michal6271/PEUS/Projekt EAGLE/zasilacz.pdf

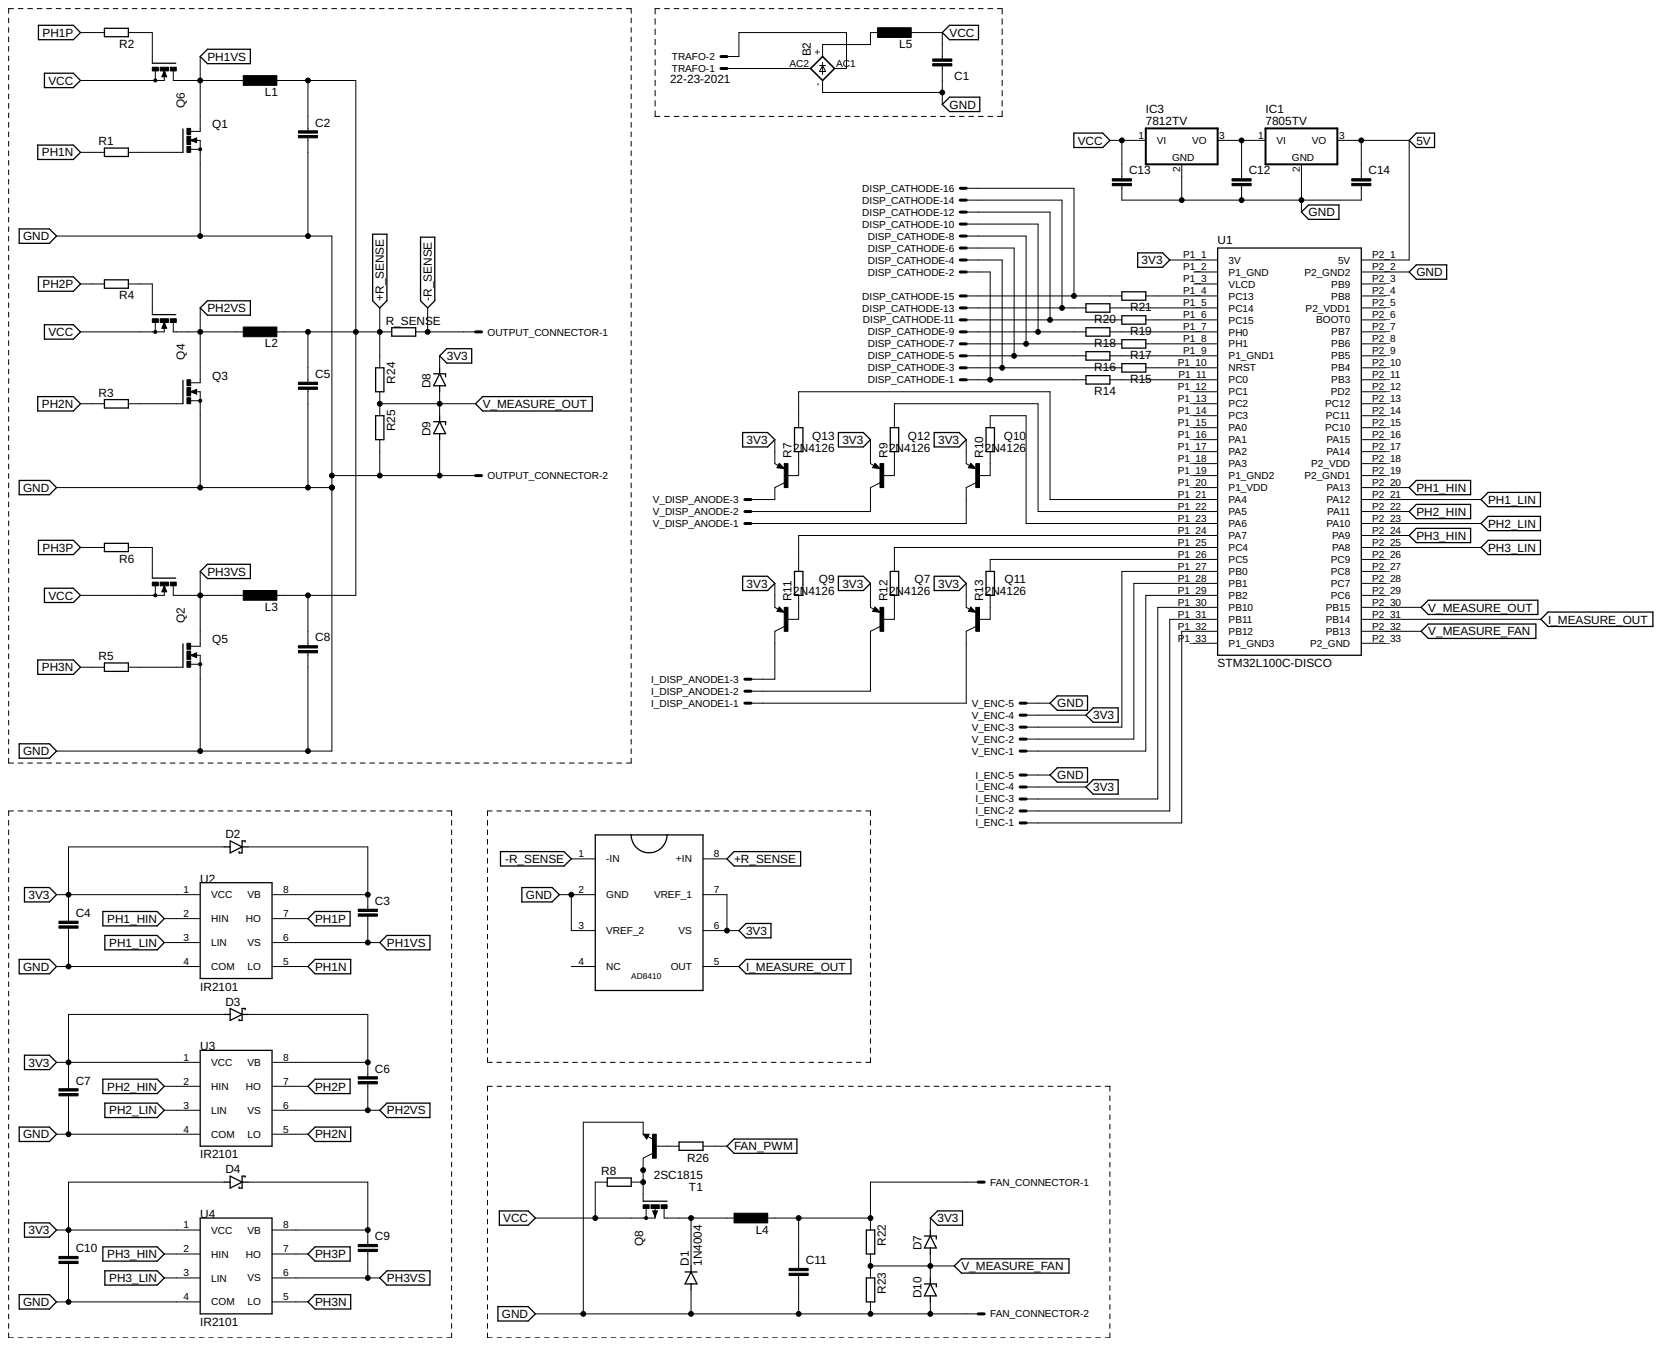
[picture p9: page 1]
