michal6271/PEUS/Projekt EAGLE/zasilacz.brd

## EAGLE design Projekt EAGLE/zasilacz.brd (2021-01-22)

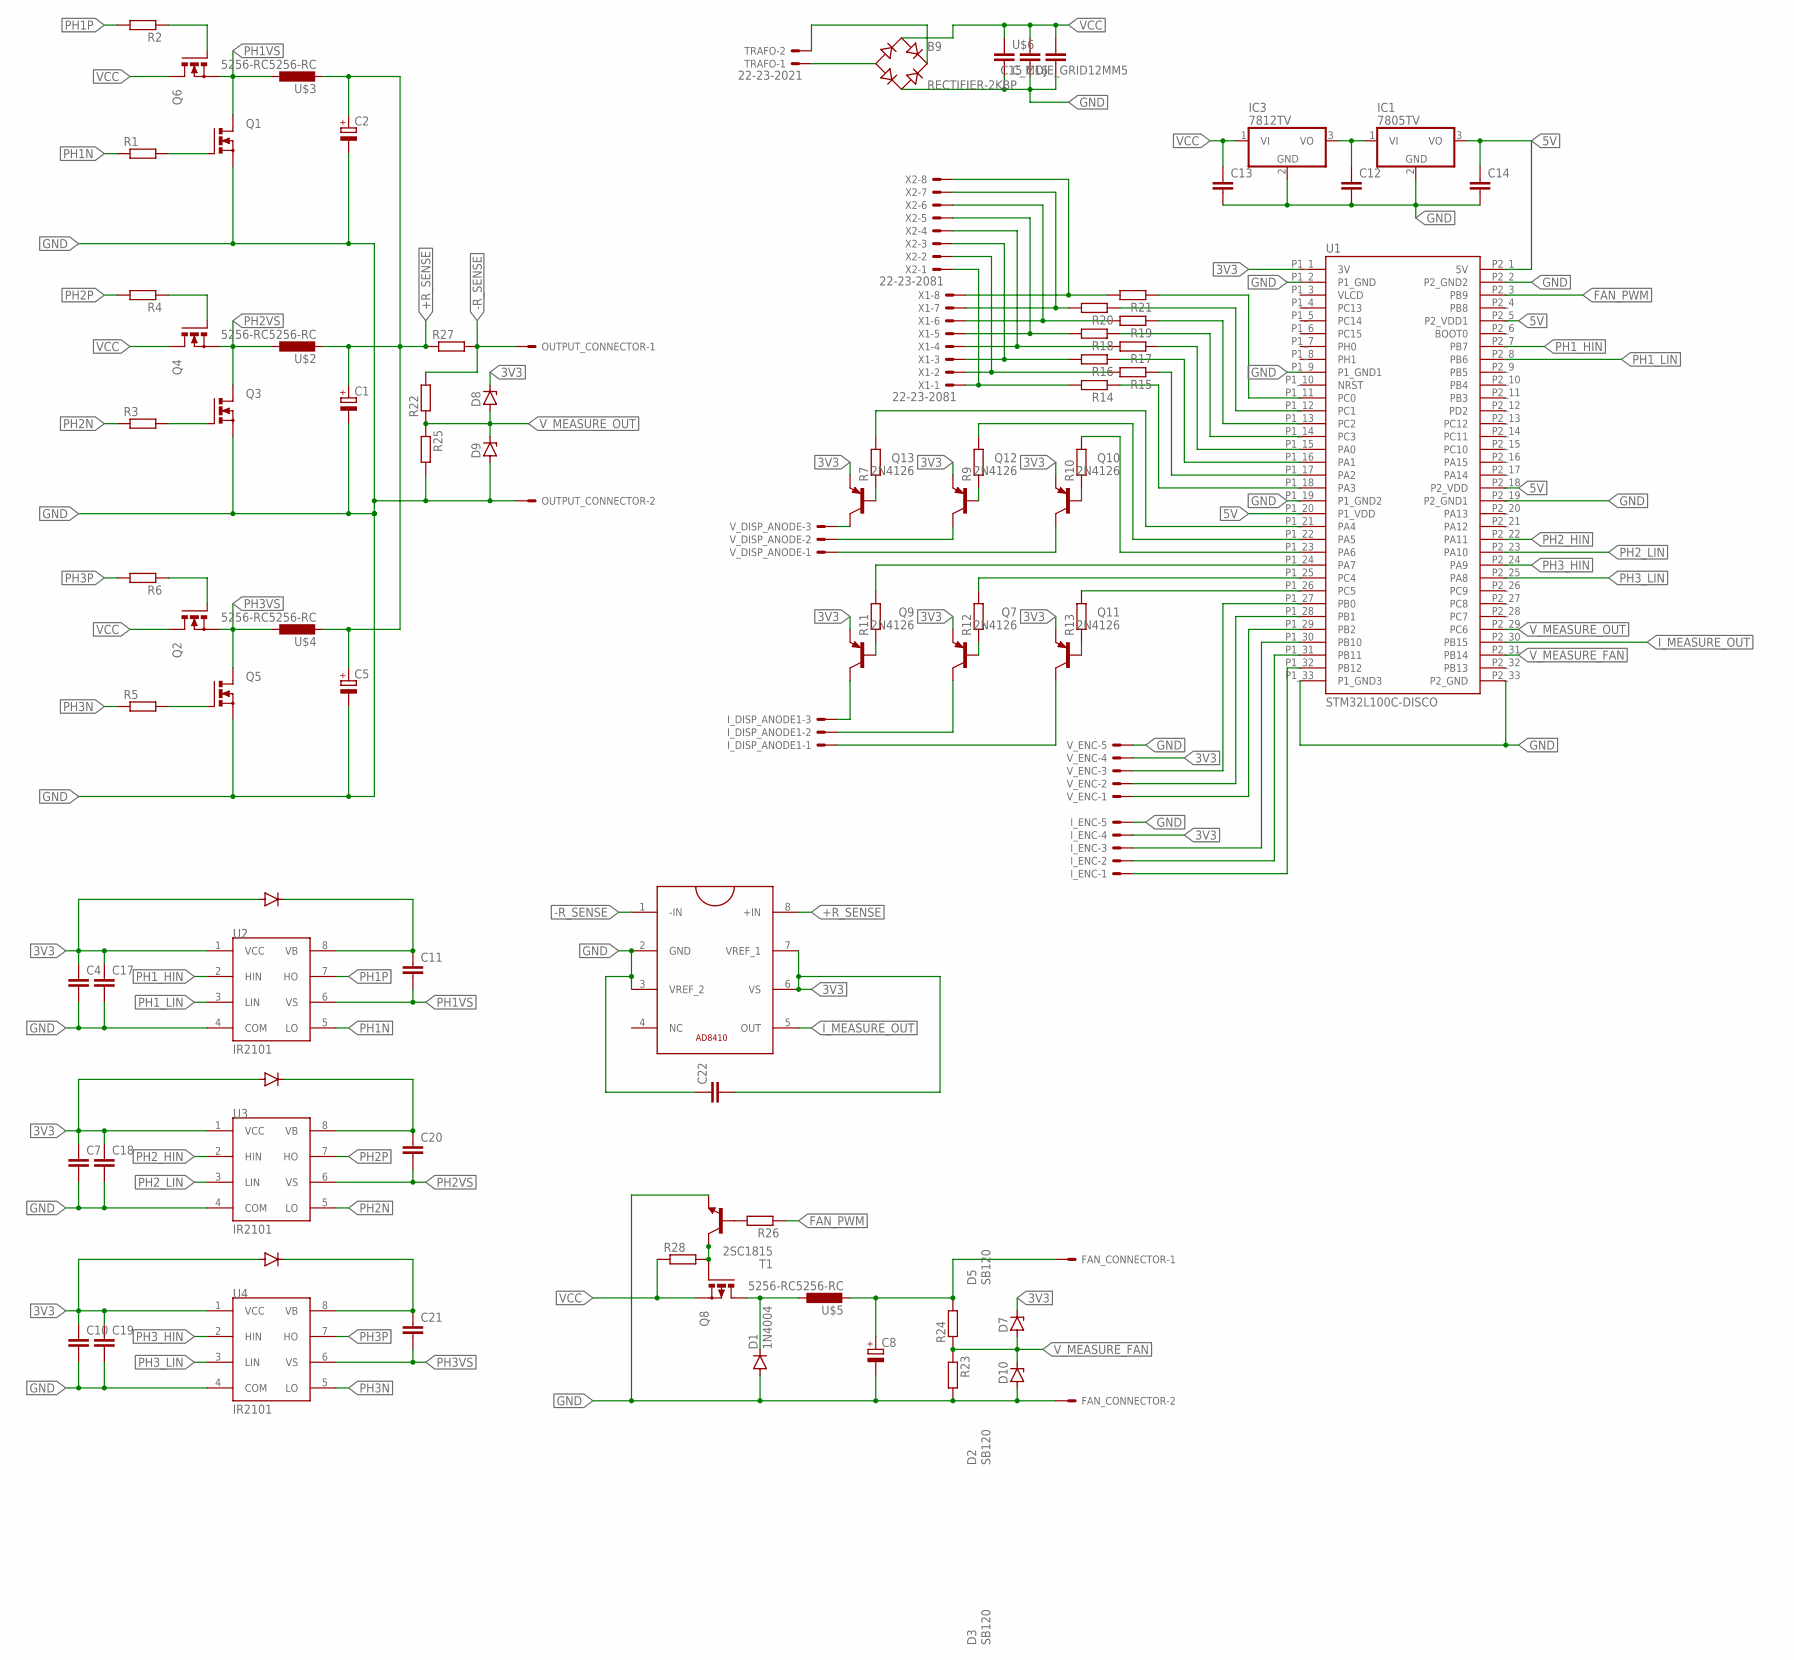
[picture p10: schematic zasilacz.sch]

Parts:
B9: RECTIFIER-2KBP; 2KBP
C1, C2, C5, C8: CPOL-EUE5-13; E5-13
C4, C7, C10, C12, C13, C14, C15, C16, C17, C18, C19, C22: C-EU025-024X044; C025-024X044
C11, C20, C21: C-EUC0603K; C0603K
D1: 1N4004; DO41-10
D2, D3, D5: SB120; DO41-10
D7, D8, D9, D10: ZENER-DIODEDO34-7; DO34Z7
FAN_CONNECTOR: 22-23-2021
IC1: 7805TV; TO220V
IC3: 7812TV; TO220V
I_DISP_ANODE1: 22-23-2031
I_ENC: 22-23-2051
OUTPUT_CONNECTOR: 22-23-2021
Q1, Q2, Q3, Q4, Q5, Q6: PMOSFET_NTO220BV; TO220BV
Q7, Q9, Q10, Q11, Q12, Q13: 2N4126; TO92-CBE
Q8: PMOSFET_PTO220BV; TO220BV
R1, R2, R3, R4, R5, R6, R7, R9, R10, R11, R12, R13, R14, R15, R16, R17, R18, R19, R20, R21, R23, R25, R26: R-EU_0309/10; 0309/10
R22, R24: R-EU_0207/12; 0207/12
R27: R-EU_R2512; R2512
R28: R-EU_0207/10; 0207/10
T1: 2SC1815; TO92-ECB
TRAFO: 22-23-2021
U1: STM32L100C-DISCO; DEV_STM32L100C-DISCO
U2, U3, U4: IR2101; DIL08
U$1: AD8410AD8410_V1; AD8410
U$2, U$3, U$4, U$5: 5256-RC5256-RC; INDAD4030W90L3300D1350B
U$6: C_MOJE_GRID12MM5; C025-030X050
V_DISP_ANODE: 22-23-2031
V_ENC: 22-23-2051
X1, X2: 22-23-2081

Connections:
3V3: C4.1, C7.1, C10.1, C17.1, C18.1, C19.1, D2.A, D3.A, D5.A, D7.C, D8.C, I_ENC.4, Q7.E, Q9.E, Q10.E, Q11.E, Q12.E, Q13.E, U1.P1_1 (3V), U2.1 (VCC), U3.1 (VCC), U4.1 (VCC), V_ENC.4
5V: C14.1, IC1.3 (VO), U1.P1_20 (P1_VDD), U1.P2_1 (5V), U1.P2_5 (P2_VDD1), U1.P2_18 (P2_VDD)
+R_SENSE: C1.+, C2.+, C5.+, R27.1, U$1.8 (+IN), U$2.2, U$3.2, U$4.2
-R_SENSE: OUTPUT_CONNECTOR.1, R22.2, R27.2, U$1.1 (-IN)
FAN_PWM: R26.1, U1.P2_3 (PB9)
GND: B9.AC2, C1.-, C2.-, C4.2, C5.-, C7.2, C8.-, C10.2, C12.2, C13.2, C14.2, C15.1, C16.1, C17.2, C18.2, C19.2, C22.1, D1.A, D9.A, D10.A, FAN_CONNECTOR.2, IC1.2 (GND), IC3.2 (GND), I_ENC.5, OUTPUT_CONNECTOR.2, Q1.S, Q3.S, Q5.S, R23.2, R25.2, T1.E, U1.P1_2 (P1_GND), U1.P1_9 (P1_GND1), U1.P1_19 (P1_GND2), U1.P1_33 (P1_GND3), U1.P2_2 (P2_GND2), U1.P2_19 (P2_GND1), U1.P2_33 (P2_GND), U2.4 (COM), U3.4 (COM), U4.4 (COM), U$1.2 (GND), U$1.3 (VREF_2), U$6.2, V_ENC.5
I_MEASURE_OUT: U1.P2_30 (PB15), U$1.5 (OUT)
unnamed: Q8.G, R28.2, T1.C
unnamed: R26.2, T1.B
unnamed: Q3.G, R3.2
unnamed: Q4.G, R4.1
unnamed: R14.1, U1.P1_18 (PA3)
unnamed: R15.1, U1.P1_17 (PA2)
unnamed: Q1.G, R1.2
unnamed: C22.2, U$1.6 (VS), U$1.7 (VREF_1)
unnamed: C12.1, IC1.1 (VI), IC3.3 (VO)
unnamed: Q6.G, R2.1
unnamed: R16.1, U1.P1_16 (PA1)
unnamed: R17.1, U1.P1_15 (PA0)
unnamed: R18.1, U1.P1_14 (PC3)
unnamed: Q5.G, R5.2
unnamed: Q2.G, R6.1
unnamed: R19.1, U1.P1_13 (PC2)
unnamed: Q13.C, V_DISP_ANODE.3
unnamed: R20.1, U1.P1_12 (PC1)
unnamed: B9.+, TRAFO.2
unnamed: Q10.B, R10.1
unnamed: R21.1, U1.P1_11 (PC0)
unnamed: Q12.B, R9.1
unnamed: B9.-, TRAFO.1
unnamed: I_ENC.1, U1.P1_32 (PB12)
unnamed: D1.C, Q8.D, U$5.1
unnamed: Q13.B, R7.1
unnamed: Q12.C, V_DISP_ANODE.2
unnamed: Q10.C, V_DISP_ANODE.1
unnamed: Q11.B, R13.1
unnamed: I_DISP_ANODE1.3, Q9.C
unnamed: I_DISP_ANODE1.2, Q7.C
unnamed: I_DISP_ANODE1.1, Q11.C
unnamed: Q7.B, R12.1
unnamed: Q9.B, R11.1
unnamed: R14.2, X1.1, X2.1
unnamed: R15.2, X1.2, X2.2
unnamed: R16.2, X1.3, X2.3
unnamed: R17.2, X1.4, X2.4
unnamed: R18.2, X1.5, X2.5
unnamed: R19.2, X1.6, X2.6
unnamed: R20.2, X1.7, X2.7
unnamed: R21.2, X1.8, X2.8
unnamed: I_ENC.2, U1.P1_31 (PB11)
unnamed: I_ENC.3, U1.P1_30 (PB10)
unnamed: U1.P1_29 (PB2), V_ENC.1
unnamed: U1.P1_28 (PB1), V_ENC.2
unnamed: U1.P1_27 (PB0), V_ENC.3
unnamed: R13.2, U1.P1_26 (PC5)
unnamed: R12.2, U1.P1_25 (PC4)
unnamed: R11.2, U1.P1_24 (PA7)
unnamed: R10.2, U1.P1_23 (PA6)
unnamed: R9.2, U1.P1_22 (PA5)
unnamed: R7.2, U1.P1_21 (PA4)
PH1N: R1.1, U2.5 (LO)
PH1P: R2.2, U2.7 (HO)
PH1VS: C11.2, Q1.D, Q6.S, U2.6 (VS), U$3.1
PH1_HIN: U1.P2_7 (PB7), U2.2 (HIN)
PH1_LIN: U1.P2_8 (PB6), U2.3 (LIN)
PH2N: R3.1, U3.5 (LO)
PH2P: R4.2, U3.7 (HO)
PH2VS: C20.2, Q3.D, Q4.S, U3.6 (VS), U$2.1
PH2_HIN: U1.P2_22 (PA11), U3.2 (HIN)
PH2_LIN: U1.P2_23 (PA10), U3.3 (LIN)
PH3N: R5.1, U4.5 (LO)
PH3P: R6.2, U4.7 (HO)
PH3VS: C21.2, Q2.S, Q5.D, U4.6 (VS), U$4.1
PH3_HIN: U1.P2_24 (PA9), U4.2 (HIN)
PH3_LIN: U1.P2_25 (PA8), U4.3 (LIN)
UWY: C8.+, FAN_CONNECTOR.1, R24.2, U$5.2
VB: C11.1, C20.1, C21.1, D2.C, D3.C, D5.C, U2.8 (VB), U3.8 (VB), U4.8 (VB)
VCC: B9.AC1, C13.1, C15.2, C16.2, IC3.1 (VI), Q2.D, Q4.D, Q6.D, Q8.S, R28.1, U$6.1
VLCD: U1.P1_3 (VLCD)
V_MEASURE_FAN: D7.A, D10.C, R23.1, R24.1, U1.P2_31 (PB14)
V_MEASURE_OUT: D8.A, D9.C, R22.1, R25.1, U1.P2_29 (PC6)

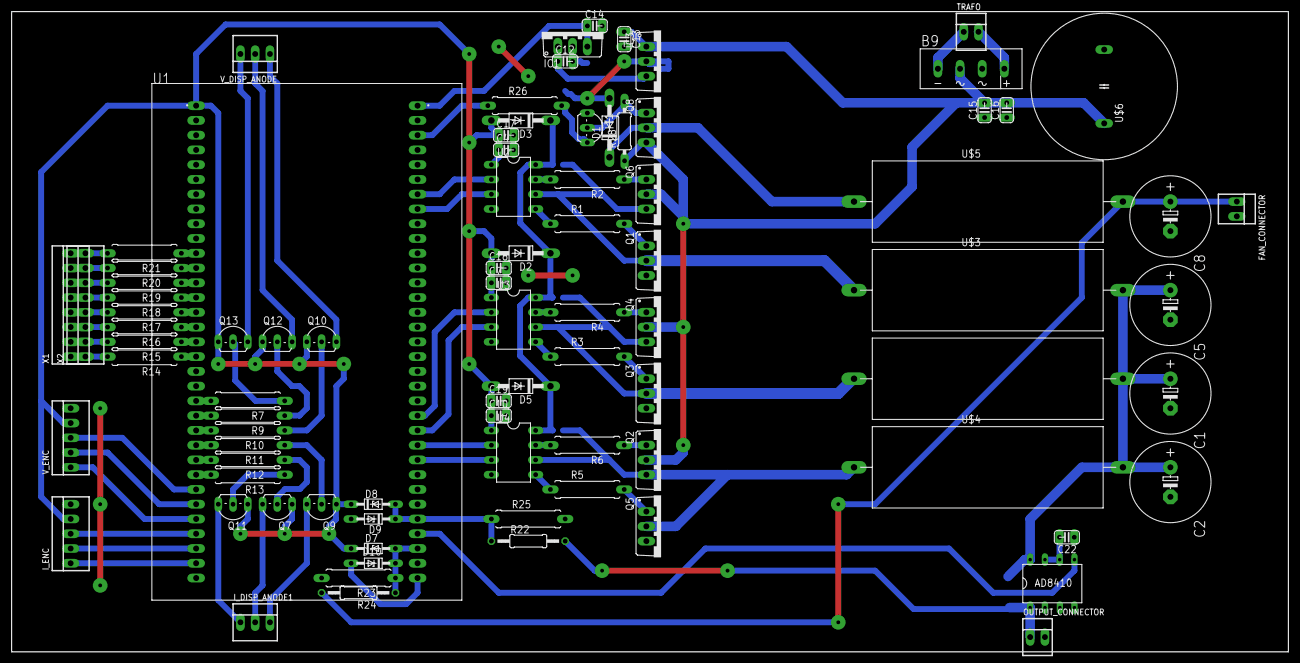
[picture p11: board zasilacz.brd from above]

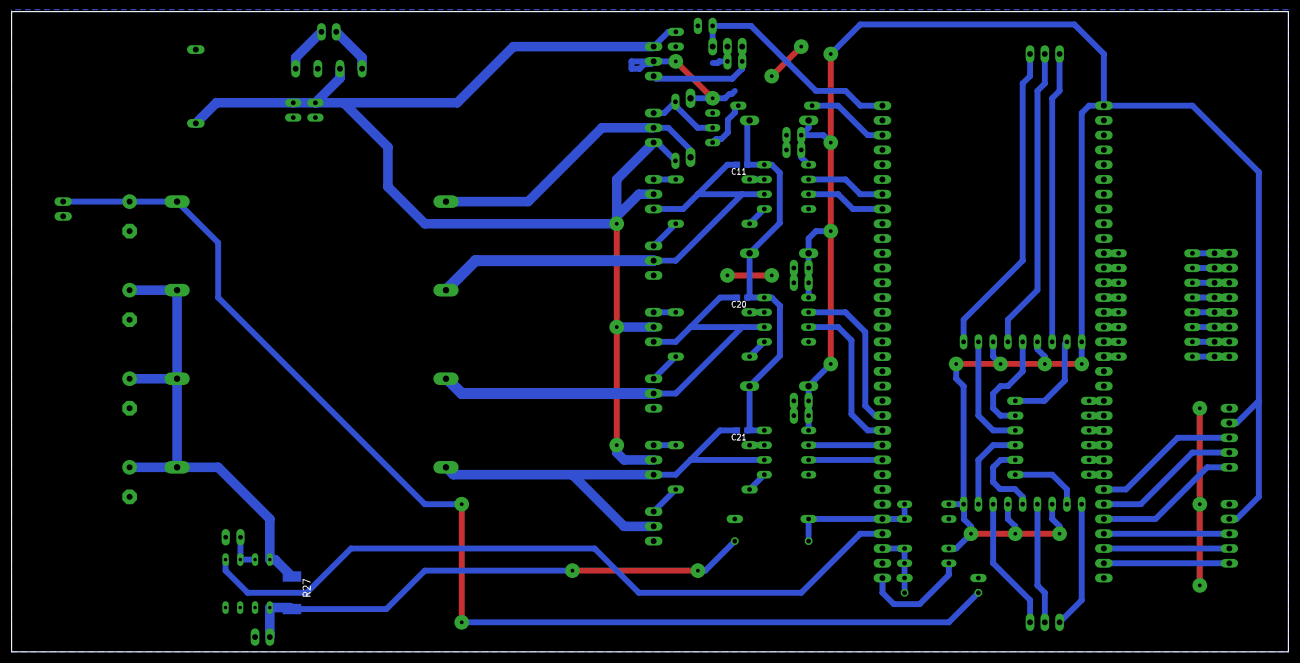
[picture p12: board zasilacz.brd from below]

Board: 2 copper layers, 219.7 x 110.2 mm, 90 parts (4 on the bottom side), 80 nets.
